owhite/MP2-DFN/Kicad_Project/DXFs/DFN_V03_3.dxf

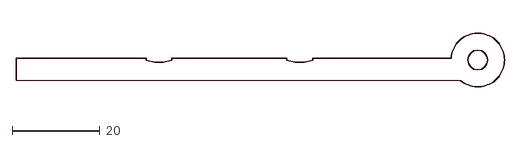
[picture p1: CAD file, 2024-06-27]
Kicad_Project/DXFs/DFN_V03_3.dxf
111.0 x 12.1
