owhite/MP2-DFN/Kicad_Project/DXFs/DFN_V03_2.dxf

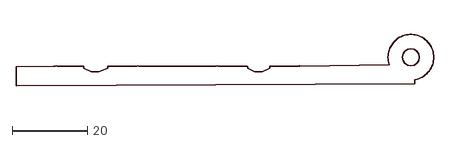
[picture p2: CAD file, 2024-06-27, an earlier design]
Kicad_Project/DXFs/DFN_V03_2.dxf
111.0 x 13.6
