owhite/MP2-DFN/Kicad_Project/DXFs/DFN_V03_1.dxf

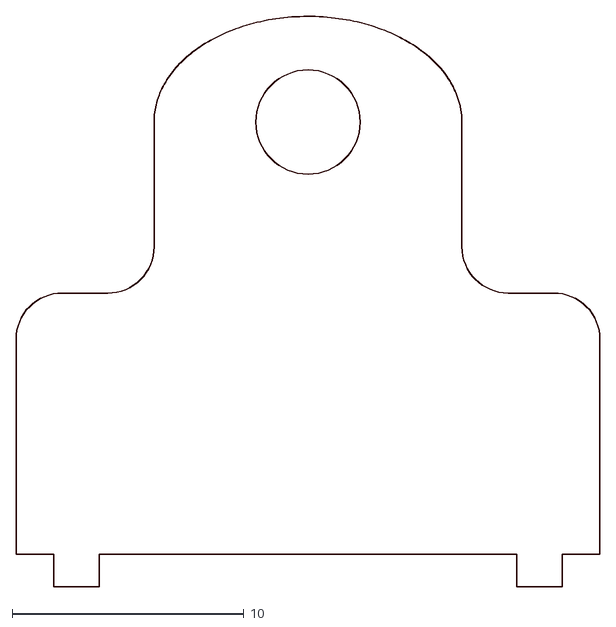
[picture p3: CAD file, 2024-06-27, an earlier design]
Kicad_Project/DXFs/DFN_V03_1.dxf
25.2 x 24.6
