owhite/MP2-DFN/Kicad_Project/scrap.kicad_sch

## KiCad design Kicad_Project/scrap.kicad_sch (2024-06-17)

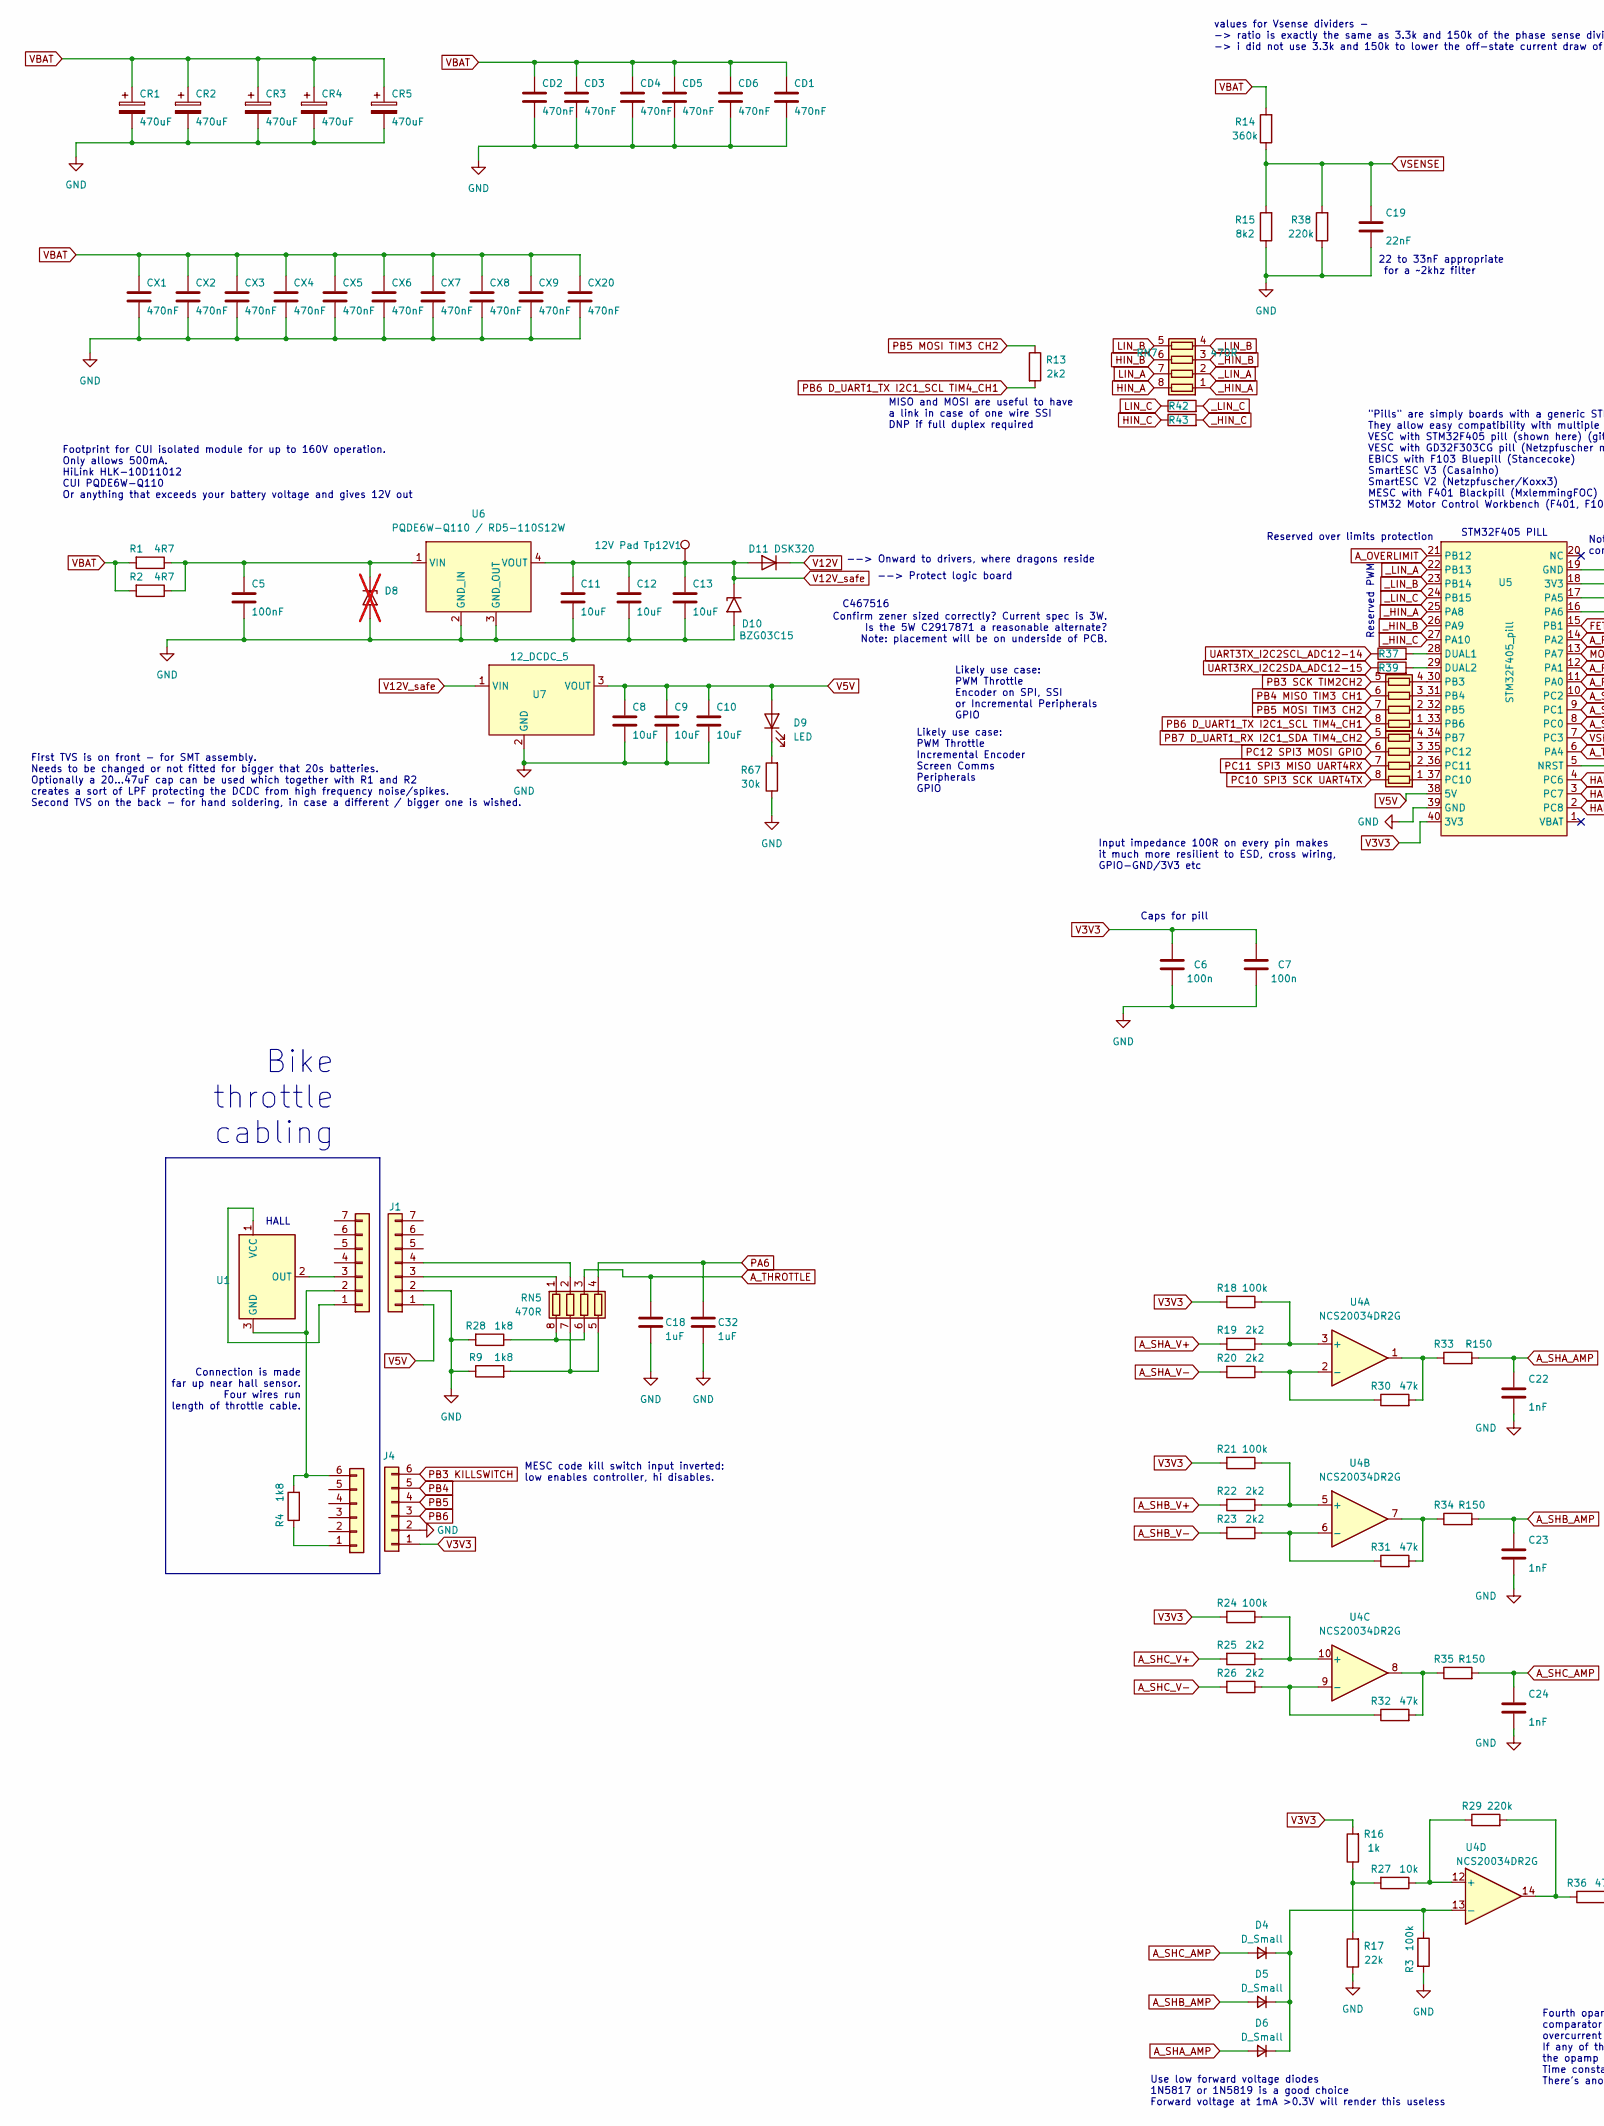
[picture p4: schematic scrap.kicad_sch, part in row 1, column 1]

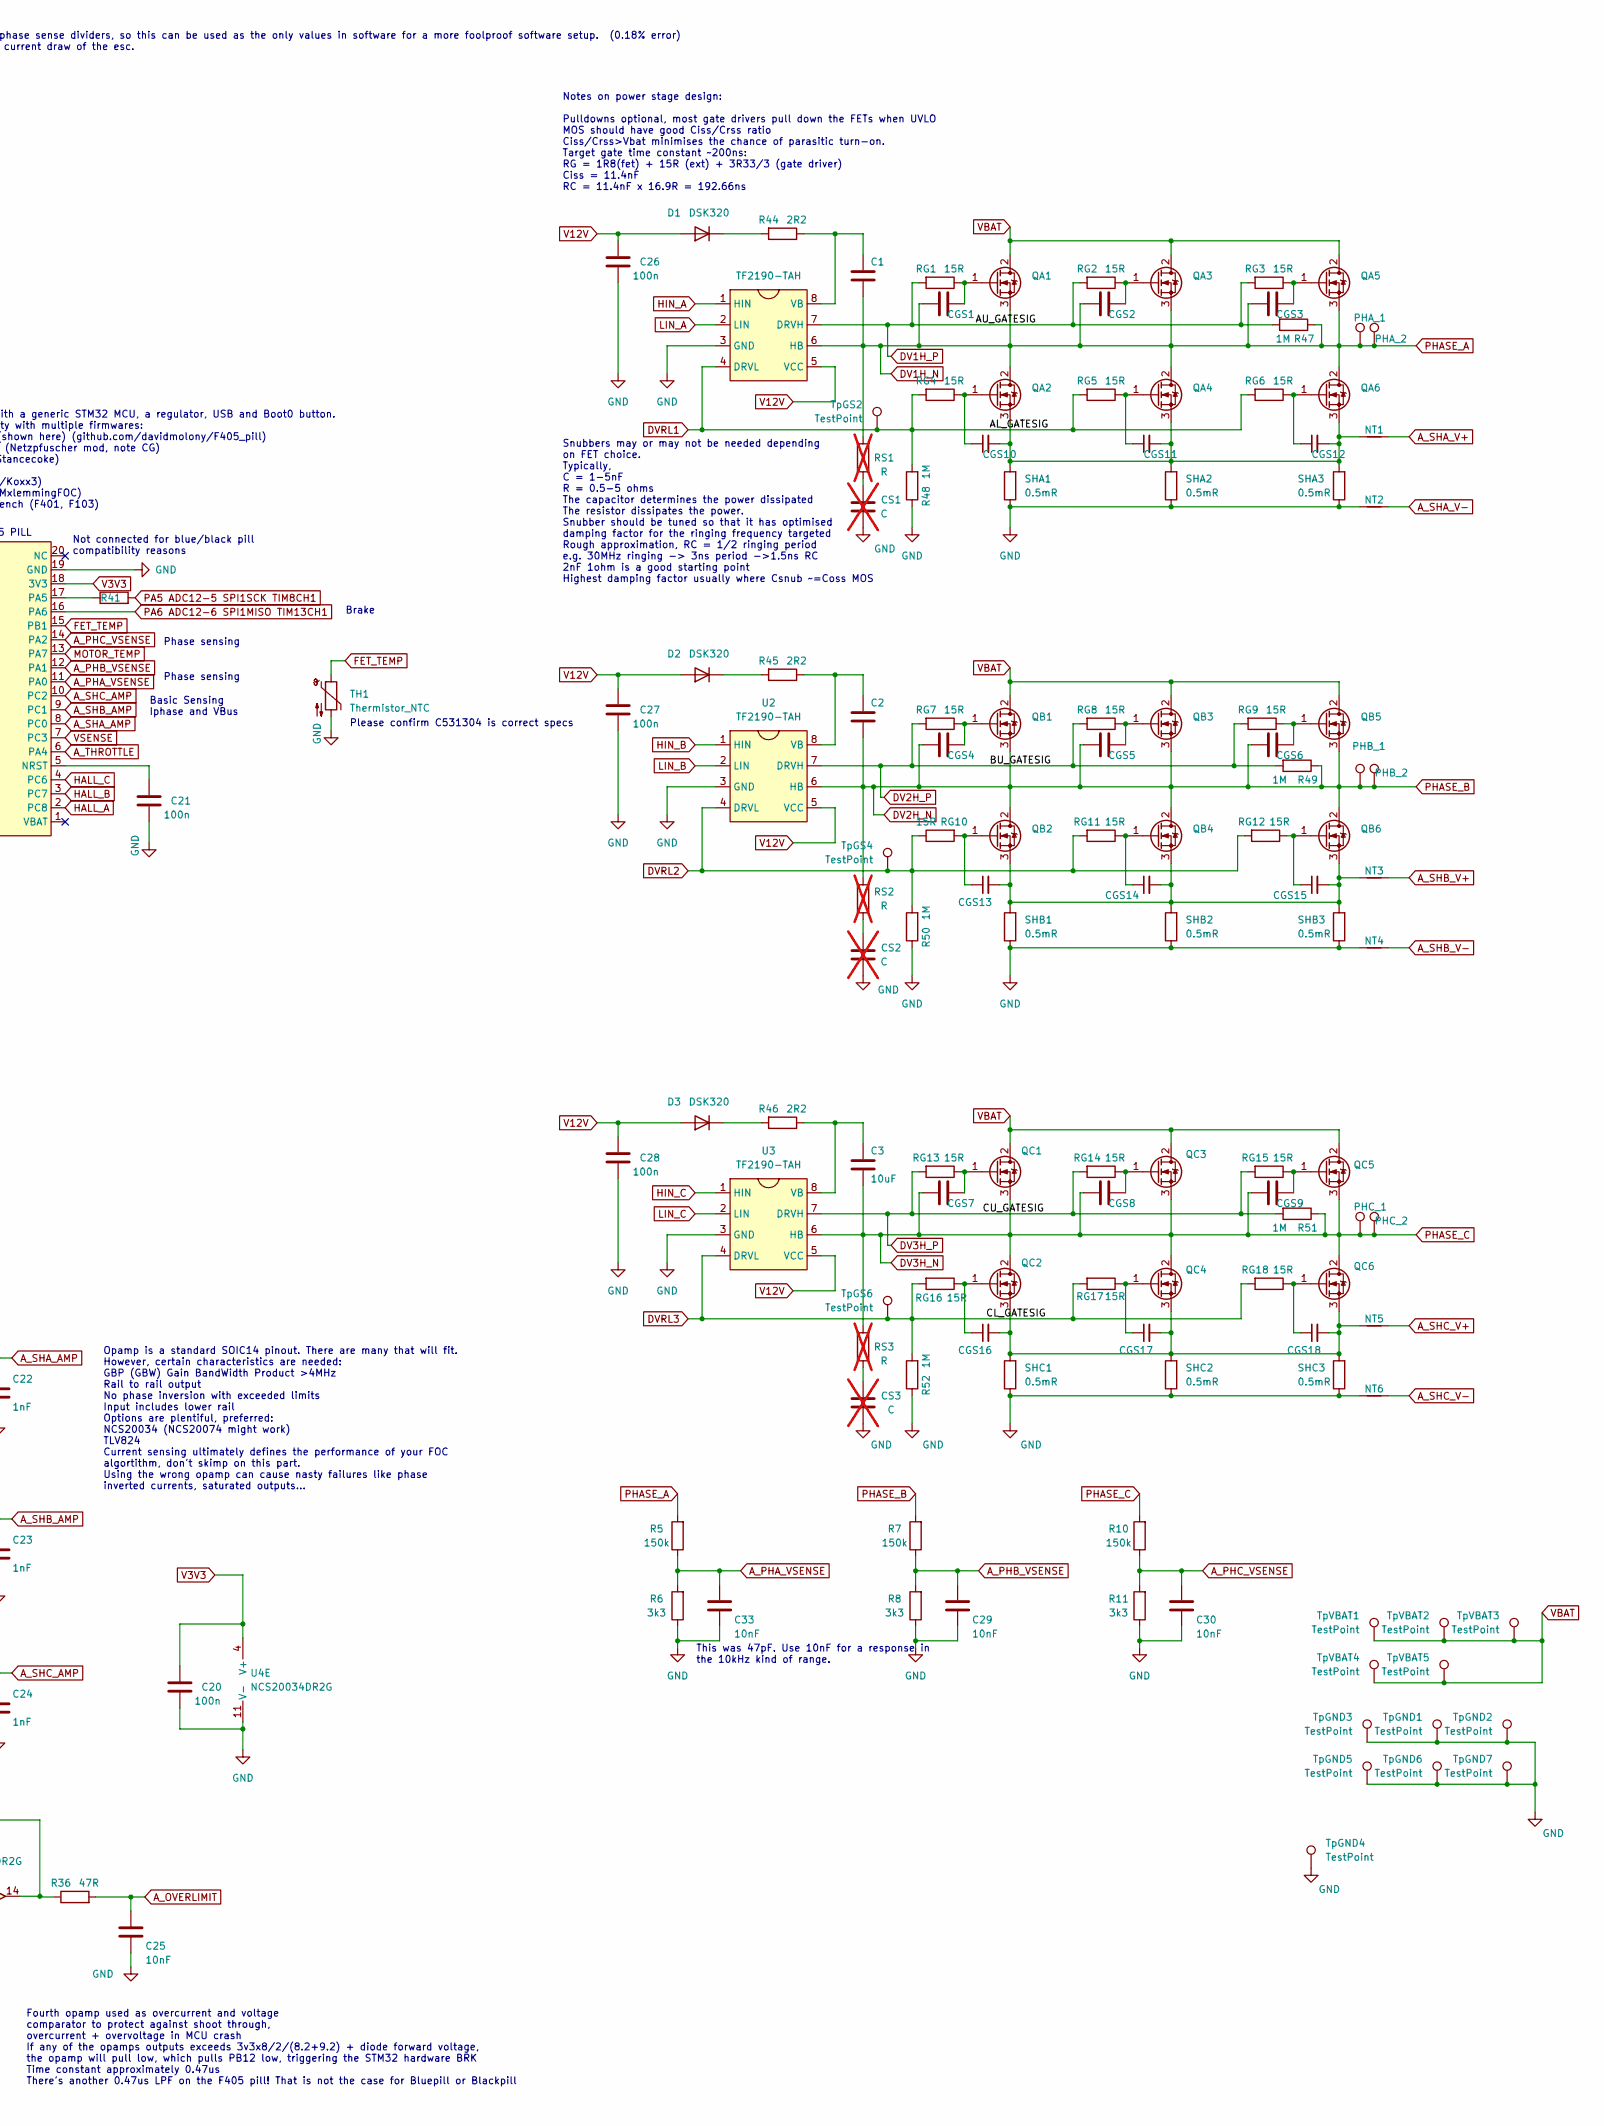
[picture p5: schematic scrap.kicad_sch, part in row 1, column 2]

Parts:
C1, C2, C3, C8, C9, C10, C11, C12, C13: 10uF; C_0603_1608Metric; LCSC C96446
C5: 100nF; C_0805_2012Metric; LCSC C342865
C6, C7, C20, C21, C26, C27, C28: 100n; C_0603_1608Metric; LCSC C14663
C18, C32: 1uF; C_0603_1608Metric; LCSC C15849
C19: 22nF; C_0603_1608Metric; LCSC C21122
C22, C23, C24: 1nF; C_0603_1608Metric; LCSC C1588
C25, C29, C30, C33: 10nF; C_0603_1608Metric; LCSC C57112
CD1, CD2, CD3, CD4, CD5, CD6: 470nF; C_1210_3225Metric; LCSC C192761
CGS1, CGS2, CGS3, CGS4, CGS5, CGS6, CGS7, CGS8, CGS9, CGS10, CGS11, CGS12, CGS13, CGS14, CGS15, CGS16, CGS17, CGS18: 4.7nF; C_0603_1608Metric; LCSC C597214
CR1, CR2, CR3, CR4, CR5: 470uF; CP_Radial_D18.0mm_P7.50mm
CS1, CS2, CS3: C; C_0805_2012Metric; not fitted
CX1, CX2, CX3, CX4, CX5, CX6, CX7, CX8, CX9, CX20: 470nF; C_1210_3225Metric; LCSC C192761
D1, D2, D3, D11: DSK320; D_SOD-123; LCSC C5290222
D4, D5, D6: D_Small; D_SOD-323; LCSC C191023
D8: D_SMC_Handsoldering; not fitted
D9: LED; D_0603_1608Metric; LCSC C72041
D10: BZG03C15; D_SMA; LCSC C467516
J1, J3: Conn_01x07; JST_PH_B7B-PH-K_1x07_P2.00mm_Vertical
J2, J4: Conn_01x06; JST_PH_B6B-PH-K_1x06_P2.00mm_Vertical
NT1, NT2, NT3, NT4, NT5, NT6: NetTie_2; NetTie-2_SMD_Pad0.5mm
PHA_1, PHA_2: PhasePad; my_2mm_slot
PHB_1, PHB_2: PhasePad; my_2mm_slot
PHC_1, PHC_2: PhasePad; my_2mm_slot
QA1, QA2, QA3, QA4, QA5, QA6: NVMTSC4D3N15MC; custom_NVMTSC4D3N15MC; LCSC C3280341
QB1, QB2, QB3, QB4, QB5, QB6: NVMTSC4D3N15MC; custom_NVMTSC4D3N15MC; LCSC C3280341
QC1, QC2, QC3, QC4, QC5, QC6: NVMTSC4D3N15MC; custom_NVMTSC4D3N15MC; LCSC C3280341
R1, R2: 4R7; R_0805_2012Metric; LCSC C17675
R3, R18, R21, R24: 100k; R_0603_1608Metric; LCSC C25803
R4, R9, R28: 1k8; R_0603_1608Metric; LCSC C4177
R5, R7, R10: 150k; R_0805_2012Metric; LCSC C17470
R6, R8, R11: 3k3; R_0603_1608Metric; LCSC C22978
R13, R19, R20, R22, R23, R25, R26: 2k2; R_0603_1608Metric; LCSC C4190
R14: 360k; R_0805_2012Metric; LCSC C17645
R15: 8k2; R_0603_1608Metric; LCSC C25981
R16: 1k; R_0603_1608Metric; LCSC C21190
R17: 22k; R_0603_1608Metric; LCSC C31850
R27: 10k; R_0603_1608Metric; LCSC C25804
R29, R38: 220k; R_0603_1608Metric; LCSC C22961
R30, R31, R32: 47k; R_0603_1608Metric; LCSC C25819
R33, R34, R35: R150; R_0603_1608Metric; LCSC C22808
R36: 47R; R_0603_1608Metric; LCSC C23182
R37, R39, R41: R100; R_0603_1608Metric; LCSC C22775
R42, R43: R470; R_0603_1608Metric; LCSC C23179
R44, R45, R46: 2R2; R_0603_1608Metric; LCSC C22939
R47, R48, R49, R50, R51, R52: 1M; R_0603_1608Metric; LCSC C22935
R67: 30k; R_0603_1608Metric; LCSC C22984
RG1, RG2, RG3, RG4, RG5, RG6, RG7, RG8, RG9, RG10, RG11, RG12, RG13, RG14, RG15, RG16, RG17, RG18: 15R; R_0603_1608Metric; LCSC C22810
RN2, RN3, RN5, RN7: 470R; R_Array_Concave_4x0603; LCSC C25510
RS1, RS2, RS3: R; R_0805_2012Metric; not fitted
SHA1, SHA2, SHA3: 0.5mR; Shunt_2512_6332Metric; LCSC C710260
SHB1, SHB2, SHB3: 0.5mR; Shunt_2512_6332Metric; LCSC C710260
SHC1, SHC2, SHC3: 0.5mR; Shunt_2512_6332Metric; LCSC C710260
TH1: Thermistor_NTC; R_0603_1608Metric; LCSC C531304
Tp12V1: 12V Pad; TestPoint_THTPad_D2.0mm_Drill1.0mm
TpGND1, TpGND2, TpGND3, TpGND5, TpGND6, TpGND7: TestPoint; my_testpoint_D1.7mm
TpGND4: TestPoint; TestPoint_THTPad_D3.0mm_Drill1.5mm
TpGS2: TestPoint; TestPoint_THTPad_D4.0mm_Drill2.0mm
TpGS4, TpGS6: TestPoint; TestPoint_THTPad_D1.5mm_Drill0.7mm
TpVBAT1, TpVBAT2, TpVBAT3, TpVBAT4, TpVBAT5: TestPoint; my_testpoint_D1.7mm
U1, U2, U3: TF2190-TAH; SOIC-8_3.9x4.9mm_P1.27mm; LCSC C2917161
U4: NCS20034DR2G; SOIC-14_3.9x8.7mm_P1.27mm; LCSC C695777
U5: STM32F405_pill
U6: PQDE6W-Q110 / RD5-110S12W; PQDE6W
U7: 12_DCDC_5

Connections:
A_OVERLIMIT: C25.1, R36.2, U5.21 (PB12)
A_PHA_VSENSE: C33.1, R5.1, R6.2, U5.11 (PA0)
A_PHB_VSENSE: C29.1, R7.1, R8.2, U5.12 (PA1)
A_PHC_VSENSE: C30.1, R10.1, R11.2, U5.14 (PA2)
A_SHA_AMP: C22.1, D6.2 (A), R33.2, U5.8 (PC0)
A_SHA_V+: NT1.2, R19.2
A_SHA_V-: NT2.2, R20.2
A_SHB_AMP: C23.1, D5.2 (A), R34.2, U5.9 (PC1)
A_SHB_V+: NT3.2, R22.2
A_SHB_V-: NT4.2, R23.2
A_SHC_AMP: C24.1, D4.2 (A), R35.2, U5.10 (PC2)
A_SHC_V+: NT5.2, R25.2
A_SHC_V-: NT6.2, R26.2
A_THROTTLE: C18.1, RN5.3 (R3.1), U5.6 (PA4)
DV1H_N: C1.2, CGS1.1, CGS2.1, CGS3.1, PHA_1.1, PHA_2.1, QA1.3, QA2.2, QA3.3, QA4.2, QA5.3, QA6.2, R5.2, R47.1, RS1.2, U1.6 (HB)
DV1H_P: R47.2, RG1.2, RG2.2, RG3.2, U1.7 (DRVH)
DV2H_N: C2.2, CGS4.1, CGS5.1, CGS6.1, PHB_1.1, PHB_2.1, QB1.3, QB2.2, QB3.3, QB4.2, QB5.3, QB6.2, R7.2, R49.1, RS2.2, U2.6 (HB)
DV2H_P: R49.2, RG7.2, RG8.2, RG9.2, U2.7 (DRVH)
DV3H_N: C3.2, CGS7.1, CGS8.1, CGS9.1, PHC_1.1, PHC_2.1, QC1.3, QC2.2, QC3.3, QC4.2, QC5.3, QC6.2, R10.2, R51.1, RS3.2, U3.6 (HB)
DV3H_P: R51.2, RG13.2, RG14.2, RG15.2, U3.7 (DRVH)
DVRL1: R48.2, RG4.2, RG5.2, RG6.2, TpGS2.1, U1.4 (DRVL)
DVRL2: R50.2, RG10.1, RG11.2, RG12.2, TpGS4.1, U2.4 (DRVL)
DVRL3: R52.2, RG16.2, RG17.2, RG18.2, TpGS6.1, U3.4 (DRVL)
FET_TEMP: TH1.1, U5.15 (PB1)
GND: C5.2, C6.2, C7.2, C8.2, C9.2, C10.2, C11.2, C12.2, C13.2, C18.2, C19.2, C20.2, C21.2, C22.2, C23.2, C24.2, C25.2, C26.2, C27.2, C28.2, C29.2, C30.2, C32.2, C33.2, CD1.2, CD2.2, CD3.2, CD4.2, CD5.2, CD6.2, CR1.2, CR2.2, CR3.2, CR4.2, CR5.2, CS1.1, CS2.1, CS3.1, CX1.2, CX2.2, CX3.2, CX4.2, CX5.2, CX6.2, CX7.2, CX8.2, CX9.2, CX20.2, D8.2 (A2), D10.2 (A2), J1.2, J4.2, NT2.1, NT4.1, NT6.1, R3.2, R6.1, R8.1, R9.1, R11.1, R15.1, R17.1, R28.2, R38.1, R48.1, R50.1, R52.1, R67.1, SHA1.1, SHA2.1, SHA3.1, SHB1.1, SHB2.1, SHB3.1, SHC1.1, SHC2.1, SHC3.1, TH1.2, TpGND1.1, TpGND2.1, TpGND3.1, TpGND4.1, TpGND5.1, TpGND6.1, TpGND7.1, U1.3 (GND), U2.3 (GND), U3.3 (GND), U4.11 (V-), U5.19 (GND), U5.39 (GND), U6.2 (GND_IN), U6.3 (GND_OUT), U7.2 (GND)
HALL_A: U5.2 (PC8)
HALL_B: U5.3 (PC7)
HALL_C: U5.4 (PC6)
HIN_A: RN7.8 (R1.2), U1.1 (VCC)
HIN_B: RN7.6 (R3.2), U2.1 (HIN)
HIN_C: R43.1, U3.1 (HIN)
LIN_A: RN7.7 (R2.2), U1.2 (OUT)
LIN_B: RN7.5 (R4.2), U2.2 (LIN)
LIN_C: R42.1, U3.2 (LIN)
MOTOR_TEMP: U5.13 (PA7)
unnamed: C1.1, R44.1, U1.8 (VB)
unnamed: C2.1, R45.1, U2.8 (VB)
unnamed: C3.1, R46.1, U3.8 (VB)
unnamed: C5.1, D8.1 (A1), R1.1, R2.1, U6.1 (VIN)
unnamed: C21.1, U5.5 (NRST)
unnamed: CGS1.2, QA1.1, RG1.1
unnamed: CGS2.2, QA3.1, RG2.1
unnamed: CGS3.2, QA5.1, RG3.1
unnamed: CGS4.2, QB1.1, RG7.1
unnamed: CGS5.2, QB3.1, RG8.1
unnamed: CGS6.2, QB5.1, RG9.1
unnamed: CGS7.2, QC1.1, RG13.1
unnamed: CGS8.2, QC3.1, RG14.1
unnamed: CGS9.2, QC5.1, RG15.1
unnamed: CGS10.1, QA2.1, RG4.1
unnamed: CGS10.2, CGS11.2, CGS12.2, NT1.1, QA2.3, QA4.3, QA6.3, SHA1.2, SHA2.2, SHA3.2
unnamed: CGS11.1, QA4.1, RG5.1
unnamed: CGS12.1, QA6.1, RG6.1
unnamed: CGS13.1, QB2.1, RG10.2
unnamed: CGS13.2, CGS14.2, CGS15.2, NT3.1, QB2.3, QB4.3, QB6.3, SHB1.2, SHB2.2, SHB3.2
unnamed: CGS14.1, QB4.1, RG11.1
unnamed: CGS15.1, QB6.1, RG12.1
unnamed: CGS16.1, QC2.1, RG16.1
unnamed: CGS16.2, CGS17.2, CGS18.2, NT5.1, QC2.3, QC4.3, QC6.3, SHC1.2, SHC2.2, SHC3.2
unnamed: CGS17.1, QC4.1, RG17.1
unnamed: CGS18.1, QC6.1, RG18.1
unnamed: CS1.2, RS1.1
unnamed: CS2.2, RS2.1
unnamed: CS3.2, RS3.1
unnamed: D1.1 (K), R44.2
unnamed: D2.1 (K), R45.2
unnamed: D3.1 (K), R46.2
unnamed: D4.1 (K), D5.1 (K), D6.1 (K), R3.1, U4.13 (-)
unnamed: D9.1 (K), R67.2
unnamed: J1.3, RN5.1 (R1.1)
unnamed: J1.4, RN5.2 (R2.1)
unnamed: J2.1, R4.1
unnamed: J2.6, J3.2, R4.2, U1.3 (GND)
unnamed: J3.1, U1.1 (VCC)
unnamed: J3.3, U1.2 (OUT)
unnamed: R9.2, RN5.5 (R4.2), RN5.7 (R2.2)
unnamed: R16.1, R17.2, R27.2
unnamed: R18.1, R19.1, U4.3 (+)
unnamed: R20.1, R30.1, U4.2 (-)
unnamed: R21.1, R22.1, U4.5 (+)
unnamed: R23.1, R31.1, U4.6 (-)
unnamed: R24.1, R25.1, U4.10 (+)
unnamed: R26.1, R32.1, U4.9 (-)
unnamed: R27.1, R29.1, U4.12 (+)
unnamed: R28.1, RN5.6 (R3.2), RN5.8 (R1.2)
unnamed: R29.2, R36.1, U4.14
unnamed: R30.2, R33.1, U4.1
unnamed: R31.2, R34.1, U4.7
unnamed: R32.2, R35.1, U4.8
unnamed: R37.2, U5.28 (DUAL1)
unnamed: R39.2, U5.29 (DUAL2)
unnamed: R41.1, U5.17 (PA5)
unnamed: RN2.1 (R1.1), U5.33 (PB6)
unnamed: RN2.2 (R2.1), U5.32 (PB5)
unnamed: RN2.3 (R3.1), U5.31 (PB4)
unnamed: RN2.4 (R4.1), U5.30 (PB3)
unnamed: RN3.1 (R1.1), U5.37 (PC10)
unnamed: RN3.2 (R2.1), U5.36 (PC11)
unnamed: RN3.3 (R3.1), U5.35 (PC12)
unnamed: RN3.4 (R4.1), U5.34 (PB7)
PA5 ADC12-5 SPI1SCK TIM8CH1: R41.2
PA6: C32.1, RN5.4 (R4.1)
PA6 ADC12-6 SPI1MISO TIM13CH1: U5.16 (PA6)
PB3 KILLSWITCH: J4.6
PB3 SCK TIM2CH2: RN2.5 (R4.2)
PB4: J4.5
PB4 MISO TIM3 CH1: RN2.6 (R3.2)
PB5: J4.4
PB5 MOSI TIM3 CH2: R13.1, RN2.7 (R2.2)
PB6: J4.3
PB6 D_UART1_TX I2C1_SCL TIM4_CH1: R13.2, RN2.8 (R1.2)
PB7 D_UART1_RX I2C1_SDA TIM4_CH2: RN3.5 (R4.2)
PC10 SPI3 SCK UART4TX: RN3.8 (R1.2)
PC11 SPI3 MISO UART4RX: RN3.7 (R2.2)
PC12 SPI3 MOSI GPIO: RN3.6 (R3.2)
UART3RX_I2C2SDA_ADC12-15: R39.1
UART3TX_I2C2SCL_ADC12-14: R37.1
V3V3: C6.1, C7.1, C20.1, J4.1, R16.2, R18.2, R21.2, R24.2, U4.4 (V+), U5.18 (3V3), U5.40 (3V3)
V5V: C8.1, C9.1, C10.1, D9.2 (A), U5.38 (5V), U7.3 (VOUT)
V12V: C26.1, C27.1, C28.1, D1.2 (A), D2.2 (A), D3.2 (A), D11.1 (K), U1.5 (VCC), U2.5 (VCC), U3.5 (VCC)
V12V_safe: C11.1, C12.1, C13.1, D10.1 (A1), D11.2 (A), Tp12V1.1, U6.4 (VOUT), U7.1 (VIN)
VBAT: CD1.1, CD2.1, CD3.1, CD4.1, CD5.1, CD6.1, CR1.1, CR2.1, CR3.1, CR4.1, CR5.1, CX1.1, CX2.1, CX3.1, CX4.1, CX5.1, CX6.1, CX7.1, CX8.1, CX9.1, CX20.1, QA1.2, QA3.2, QA5.2, QB1.2, QB3.2, QB5.2, QC1.2, QC3.2, QC5.2, R1.2, R2.2, R14.2, TpVBAT1.1, TpVBAT2.1, TpVBAT3.1, TpVBAT4.1, TpVBAT5.1
VSENSE: C19.1, R14.1, R15.2, R38.2, U5.7 (PC3)
_HIN_A: RN7.1 (R1.1), U5.25 (PA8)
_HIN_B: RN7.3 (R3.1), U5.26 (PA9)
_HIN_C: R43.2, U5.27 (PA10)
_LIN_A: RN7.2 (R2.1), U5.22 (PB13)
_LIN_B: RN7.4 (R4.1), U5.23 (PB14)
_LIN_C: R42.2, U5.24 (PB15)

Notes on the sheet:
values for Vsense dividers - -> ratio is exactly the same as 3.3k and 150k of the phase sense dividers, so this can be used as the only values in software for a more foolproof software setup. (0.18% error) -> i did not use 3.3k and 150k to lower the off-state current draw of the esc.
--> Protect logic board
"Pills" are simply boards with a generic STM32 MCU, a regulator, USB and Boot0 button. They allow easy compatibility with multiple firmwares: VESC with STM32F405 pill (shown here) (github.com/davidmolony/F405_pill) VESC with GD32F303CG pill (Netzpfuscher mod, note CG) EBICS with F103 Bluepill (Stan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
Likely use case: PWM Throttle Incremental Encoder Screen Comms Peripherals GPIO
--> Onward to drivers, where dragons reside
Bike throttle cabling
This was 47pF. Use 10nF for a response in the 10kHz kind of range.
First TVS is on front - for SMT assembly. Needs to be changed or not fitted for bigger that 20s batteries. Optionally a 20...47uF cap can be used which together with R1 and R2 creates a sort of LPF protecting the DCDC from high frequency noise/spikes. Second TVS on the back - for hand soldering, in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
Likely use case: PWM Throttle Encoder on SPI, SSI or Incremental Peripherals GPIO
C467516
Not connected for blue/black pill compatibility reasons
Reserved over limits protection
22 to 33nF appropriate for a ~2khz filter
Fourth opamp used as overcurrent and voltage comparator to protect against shoot through, overcurrent + overvoltage in MCU crash If any of the opamps outputs exceeds 3v3x8/2/(8.2+9.2) + diode forward voltage, the opamp will pull low, which pulls PB12 low, triggering the STM32 hardware BRK Time cons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
Snubbers may or may not be needed depending on FET choice. Typically, C = 1-5nF R = 0.5-5 ohms The capacitor determines the power dissipated The resistor dissipates the power. Snubber should be tuned so that it has optimised damping factor for the ringing frequency targeted Rough approximation, RC 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
Input impedance 100R on every pin makes it much more resilient to ESD, cross wiring, GPIO-GND/3V3 etc
Opamp is a standard SOIC14 pinout. There are many that will fit. However, certain characteristics are needed: GBP (GBW) Gain BandWidth Product >4MHz Rail to rail output No phase inversion with exceeded limits Input includes lower rail Options are plentiful, preferred: NCS20034 (NCS20074 might work)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
STM32F405 PILL
Notes on power stage design: Pulldowns optional, most gate drivers pull down the FETs when UVLO MOS should have good Ciss/Crss ratio Ciss/Crss>Vbat minimises the chance of parasitic turn-on. Target gate time constant ~200ns: RG = 1R8(fet) + 15R (ext) + 3R33/3 (gate driver) Ciss = 11.4nF RC = 11.4nF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
Phase sensing
MISO and MOSI are useful to have a link in case of one wire SSI DNP if full duplex required
Brake
HALL
Please confirm C531304 is correct specs
Use low forward voltage diodes 1N5817 or 1N5819 is a good choice Forward voltage at 1mA >0.3V will render this useless
Caps for pill
Reserved PWM
Connection is made far up near hall sensor. Four wires run length of throttle cable.
MESC code kill switch input inverted: low enables controller, hi disables.
Confirm zener sized correctly? Current spec is 3W. Is the 5W C2917871 a reasonable alternate? Note: placement will be on underside of PCB.
Basic Sensing Iphase and VBus
Footprint for CUI isolated module for up to 160V operation. Only allows 500mA. HiLink HLK-10D11012 CUI PQDE6W-Q110 Or anything that exceeds your battery voltage and gives 12V out
