owhite/MP2-DFN/(commit log)

2024-06-17 minor revision to extend VBAT terminals
    [bom.csv, designators.csv, scrap.kicad_sch]
2024-06-27 updated to version 0.3
    [DFN_V03_1.dxf, DFN_V03_2.dxf, DFN_V03_3.dxf, MP2_DFN_busbars2.dxf]
